grimsteel/slam/pcb/slam.kicad_pcb

## KiCad design pcb/slam.kicad_pcb (2026-07-28)

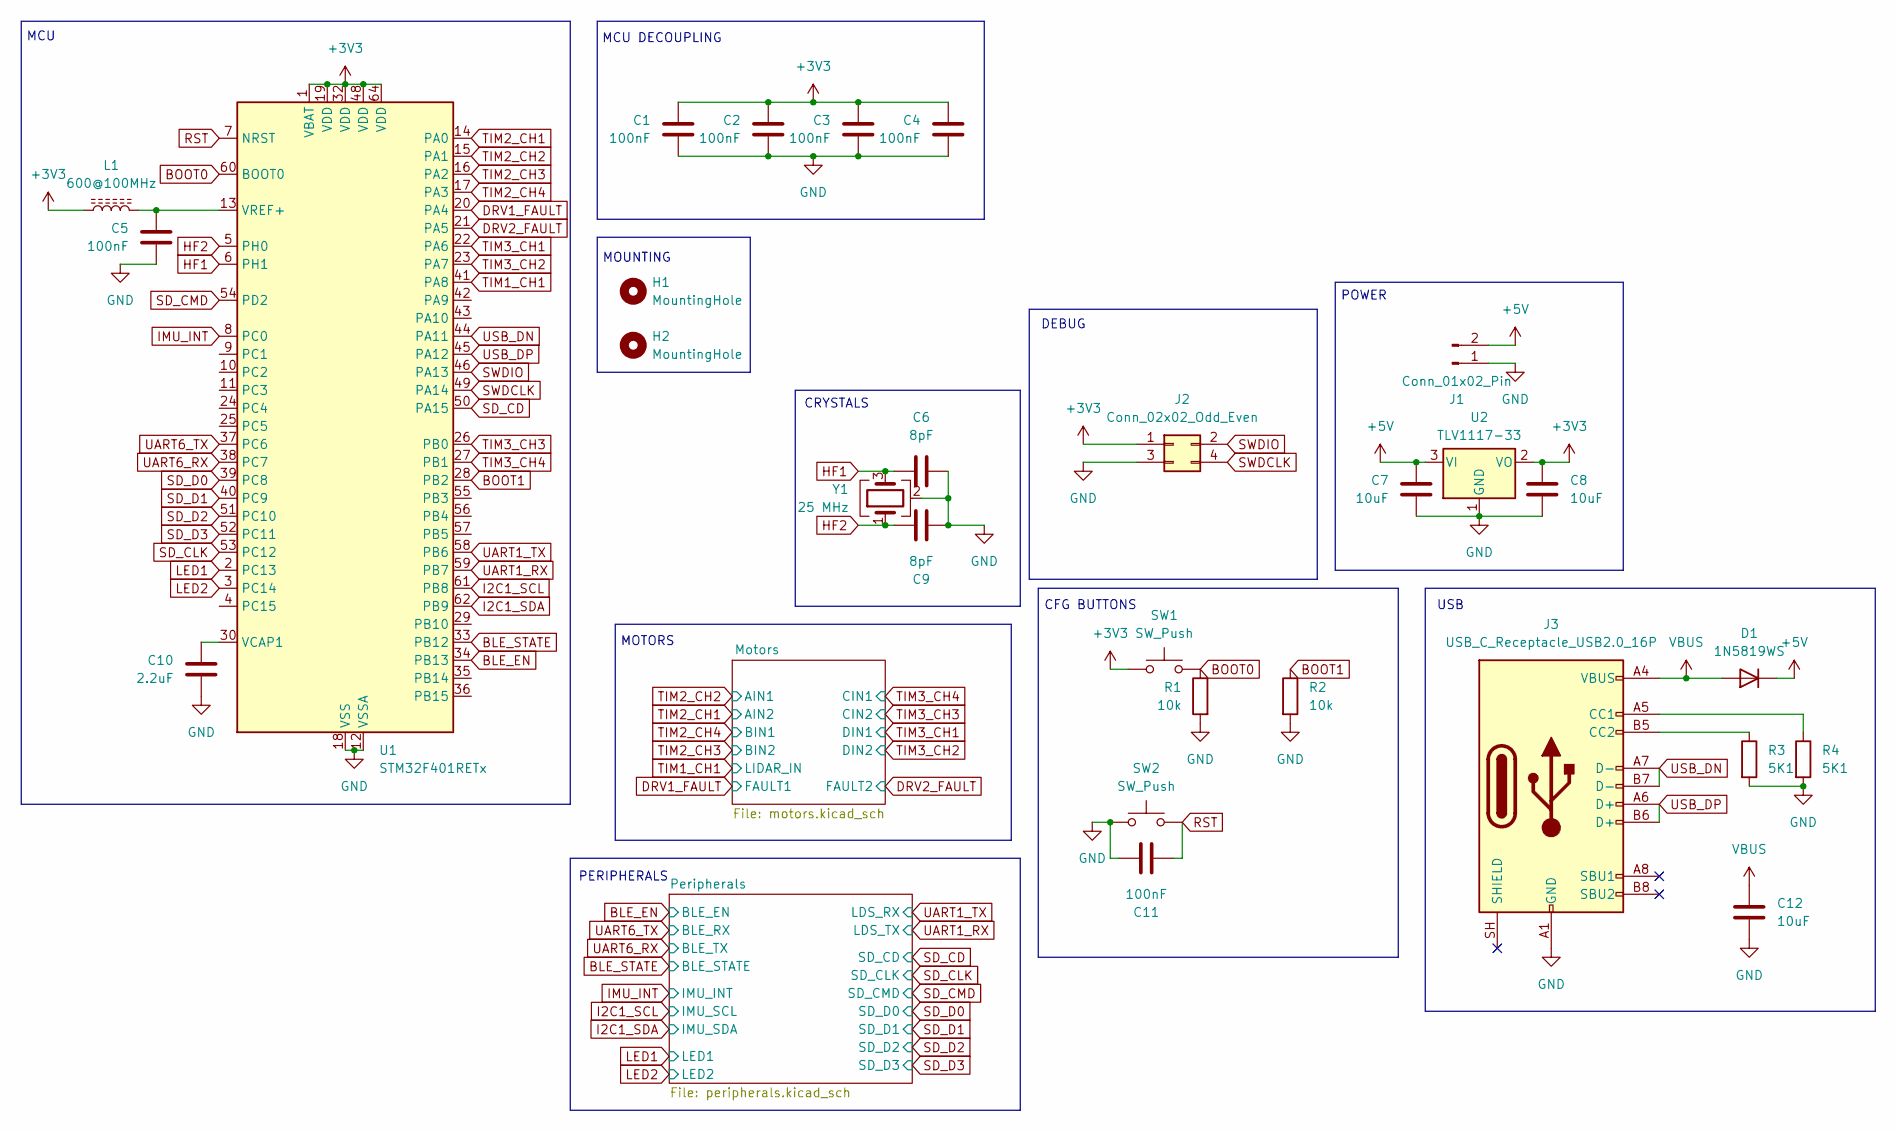
[picture p2: schematic slam.kicad_sch]

Parts:
C1, C2, C3, C4, C5, C11: 100nF; C_0805_2012Metric_Pad1.18x1.45mm_HandSolder; LCSC C3865954
C6, C9: 8pF; C_0603_1608Metric_Pad1.08x0.95mm_HandSolder; LCSC C53308513
C7, C8, C12: 10uF; C_0603_1608Metric_Pad1.08x0.95mm_HandSolder; LCSC C92487
C10: 2.2uF; C_0603_1608Metric_Pad1.08x0.95mm_HandSolder; LCSC C913904
D1: 1N5819WS; D_SOD-123; LCSC C8598
H1, H2: MountingHole; MountingHole_2.2mm_M2
J1: Conn_01x02_Pin; JST_PH_B2B-PH-K_1x02_P2.00mm_Vertical
J2: Conn_02x02_Odd_Even; PinHeader_2x02_P2.54mm_Vertical
J3: USB_C_Receptacle_USB2.0_16P; USB-C-SMD_SHOU_TYPE-C-16P-CB1.6; LCSC C2906290
L1: 600@100MHz; L_0603_1608Metric_Pad1.05x0.95mm_HandSolder; LCSC C133937
R1, R2: 10k; R_0805_2012Metric_Pad1.20x1.40mm_HandSolder; LCSC C2930231
R3, R4: 5K1; R_0603_1608Metric_Pad0.98x0.95mm_HandSolder; LCSC C23186
SW1, SW2: SW_Push; SW-SMD_L4.0-W2.9-LS5.0
U1: STM32F401RETx; LQFP-64_10x10mm_P0.5mm; LCSC C116978
U2: TLV1117-33; SOT-223-3_TabPin2; LCSC C48937499
Y1: 25 MHz; Crystal_SMD_3225-4Pin_3.2x2.5mm_HandSoldering; LCSC C2901684

Connections:
+3V3: C1.1, C2.1, C3.1, C4.1, C8.1, J2.1, L1.1, SW1.1, U1.1 (VBAT), U1.19 (VDD), U1.32 (VDD), U1.48 (VDD), U1.64 (VDD), U2.2 (VO); also elsewhere on the board
+5V: C7.1, D1.1 (K), J1.2, U2.3 (VI); also elsewhere on the board
BLE_EN: U1.34 (PB13); also elsewhere on the board
BLE_STATE: U1.33 (PB12); also elsewhere on the board
BOOT0: R1.1, SW1.2, U1.60 (BOOT0)
BOOT1: R2.1, U1.28 (PB2)
DRV1_FAULT: U1.20 (PA4); also elsewhere on the board
DRV2_FAULT: U1.21 (PA5); also elsewhere on the board
GND: C1.2, C2.2, C3.2, C4.2, C5.2, C6.1, C7.2, C8.2, C9.1, C10.2, C11.2, C12.2, J1.1, J2.3, J3.A1 (GND), J3.A12 (GND), J3.B1 (GND), J3.B12 (GND), R1.2, R2.2, R3.2, R4.2, SW2.1, U1.12 (VSSA), U1.18 (VSS), U1.31 (VSS), U1.47 (VSS), U1.63 (VSS), U2.1 (GND), Y1.2 (G), Y1.4 (G); also elsewhere on the board
HF1: C6.2, U1.6 (PH1), Y1.3
HF2: C9.2, U1.5 (PH0), Y1.1
I2C1_SCL: U1.61 (PB8); also elsewhere on the board
I2C1_SDA: U1.62 (PB9); also elsewhere on the board
IMU_INT: U1.8 (PC0); also elsewhere on the board
LED1: U1.2 (PC13); also elsewhere on the board
LED2: U1.3 (PC14); also elsewhere on the board
unnamed: J3.A5 (CC1), R4.1
unnamed: J3.B5 (CC2), R3.1
unnamed: C10.1, U1.30 (VCAP1)
unnamed: C5.1, L1.2, U1.13 (VREF+)
RST: C11.1, SW2.2, U1.7 (NRST)
SD_CD: U1.50 (PA15); also elsewhere on the board
SD_CLK: U1.53 (PC12); also elsewhere on the board
SD_CMD: U1.54 (PD2); also elsewhere on the board
SD_D0: U1.39 (PC8); also elsewhere on the board
SD_D1: U1.40 (PC9); also elsewhere on the board
SD_D2: U1.51 (PC10); also elsewhere on the board
SD_D3: U1.52 (PC11); also elsewhere on the board
SWDCLK: J2.4, U1.49 (PA14)
SWDIO: J2.2, U1.46 (PA13)
TIM1_CH1: U1.41 (PA8); also elsewhere on the board
TIM2_CH1: U1.14 (PA0); also elsewhere on the board
TIM2_CH2: U1.15 (PA1); also elsewhere on the board
TIM2_CH3: U1.16 (PA2); also elsewhere on the board
TIM2_CH4: U1.17 (PA3); also elsewhere on the board
TIM3_CH1: U1.22 (PA6); also elsewhere on the board
TIM3_CH2: U1.23 (PA7); also elsewhere on the board
TIM3_CH3: U1.26 (PB0); also elsewhere on the board
TIM3_CH4: U1.27 (PB1); also elsewhere on the board
UART1_RX: U1.59 (PB7); also elsewhere on the board
UART1_TX: U1.58 (PB6); also elsewhere on the board
UART6_RX: U1.38 (PC7); also elsewhere on the board
UART6_TX: U1.37 (PC6); also elsewhere on the board
USB_DN: J3.A7 (D-), J3.B7 (D-), U1.44 (PA11)
USB_DP: J3.A6 (D+), J3.B6 (D+), U1.45 (PA12)
VBUS: C12.1, D1.2 (A), J3.A4 (VBUS), J3.A9 (VBUS), J3.B4 (VBUS), J3.B9 (VBUS)

Notes on the sheet:
DEBUG
USB
CRYSTALS
PERIPHERALS
MOTORS
MOUNTING
POWER
MCU
CFG BUTTONS
MCU DECOUPLING

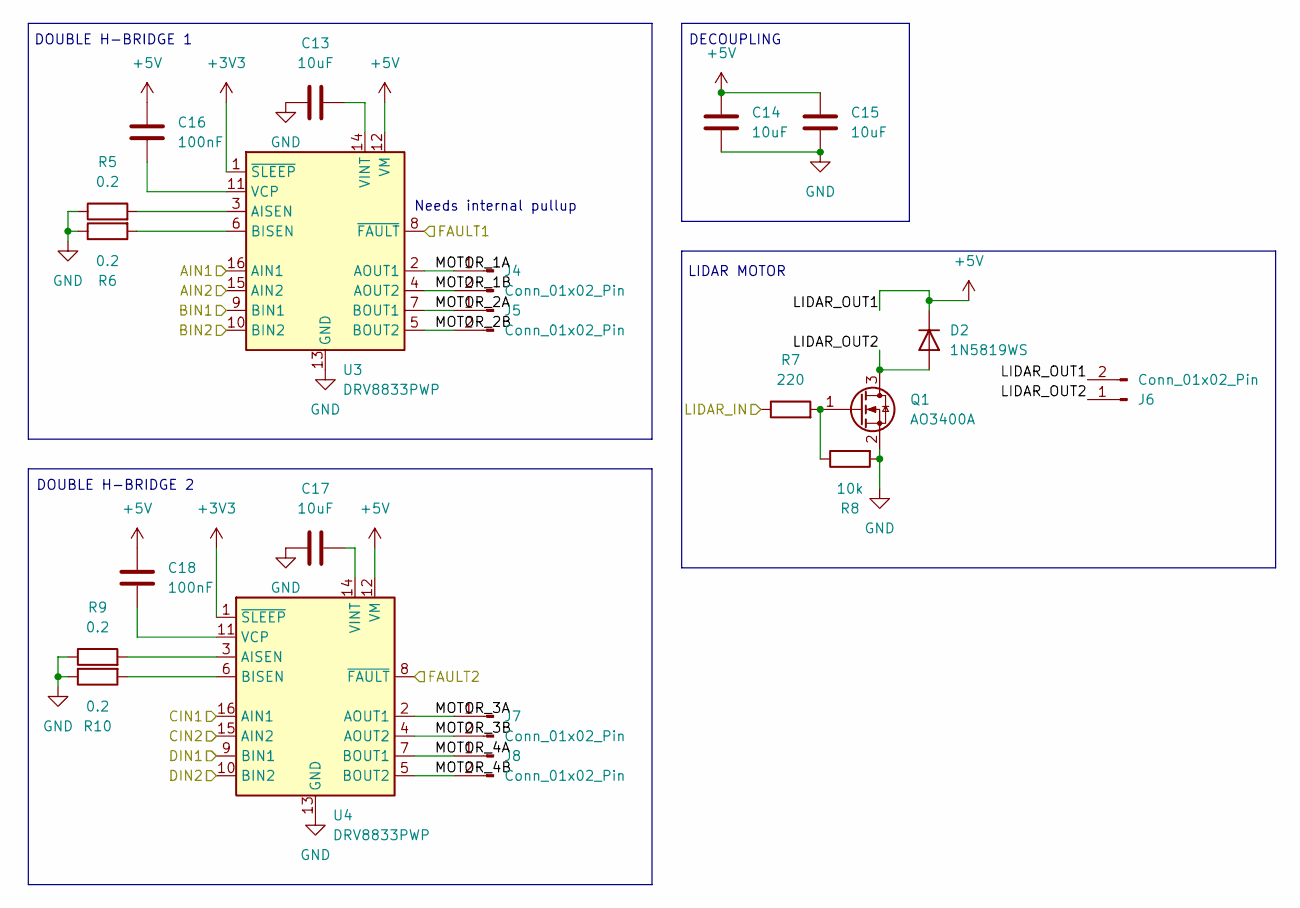
[picture p3: schematic motors.kicad_sch]

Parts:
C13, C14, C15, C17: 10uF; C_0603_1608Metric_Pad1.08x0.95mm_HandSolder; LCSC C92487
C16, C18: 100nF; C_0805_2012Metric_Pad1.18x1.45mm_HandSolder; LCSC C3865954
D2: 1N5819WS; D_SOD-123; LCSC C8598
J4, J5, J7, J8: Conn_01x02_Pin; SolderWire-0.15sqmm_1x02_P4mm_D0.5mm_OD1.5mm
J6: Conn_01x02_Pin; JST_PH_B2B-PH-K_1x02_P2.00mm_Vertical
Q1: AO3400A; SOT-23_Handsoldering; LCSC C347475
R5, R6, R9, R10: 0.2; R_1206_3216Metric_Pad1.30x1.75mm_HandSolder; LCSC C859989
R7: 220; R_0805_2012Metric_Pad1.20x1.40mm_HandSolder; LCSC C2933537
R8: 10k; R_0805_2012Metric_Pad1.20x1.40mm_HandSolder; LCSC C2930231
U3, U4: DRV8833PWP; HTSSOP-16-1EP_4.4x5mm_P0.65mm_EP3.4x5mm_Mask2.46x2.31mm; LCSC C50506

Connections:
+3V3: U3.1 (~SLEEP), U4.1 (~SLEEP); also elsewhere on the board
+5V: C14.2, C15.2, C16.1, C18.1, D2.1 (K), J6.2, U3.12 (VM), U4.12 (VM); also elsewhere on the board
/Motors/LIDAR_OUT2: D2.2 (A), J6.1, Q1.3 (D)
/Motors/MOTOR_1A: J4.1, U3.2 (AOUT1)
/Motors/MOTOR_1B: J4.2, U3.4 (AOUT2)
/Motors/MOTOR_2A: J5.1, U3.7 (BOUT1)
/Motors/MOTOR_2B: J5.2, U3.5 (BOUT2)
/Motors/MOTOR_3A: J7.1, U4.2 (AOUT1)
/Motors/MOTOR_3B: J7.2, U4.4 (AOUT2)
/Motors/MOTOR_4A: J8.1, U4.7 (BOUT1)
/Motors/MOTOR_4B: J8.2, U4.5 (BOUT2)
DRV1_FAULT: U3.8 (~FAULT); also elsewhere on the board
DRV2_FAULT: U4.8 (~FAULT); also elsewhere on the board
GND: C13.2, C14.1, C15.1, C17.2, Q1.2 (S), R5.1, R6.1, R8.2, R9.1, R10.1, U3.13 (GND), U3.17 (GND), U4.13 (GND), U4.17 (GND); also elsewhere on the board
unnamed: Q1.1 (G), R7.2, R8.1
unnamed: R5.2, U3.3 (AISEN)
unnamed: R6.2, U3.6 (BISEN)
unnamed: C16.2, U3.11 (VCP)
unnamed: C13.1, U3.14 (VINT)
unnamed: R9.2, U4.3 (AISEN)
unnamed: R10.2, U4.6 (BISEN)
unnamed: C18.2, U4.11 (VCP)
unnamed: C17.1, U4.14 (VINT)
TIM1_CH1: R7.1; also elsewhere on the board
TIM2_CH1: U3.15 (AIN2); also elsewhere on the board
TIM2_CH2: U3.16 (AIN1); also elsewhere on the board
TIM2_CH3: U3.10 (BIN2); also elsewhere on the board
TIM2_CH4: U3.9 (BIN1); also elsewhere on the board
TIM3_CH1: U4.9 (BIN1); also elsewhere on the board
TIM3_CH2: U4.10 (BIN2); also elsewhere on the board
TIM3_CH3: U4.15 (AIN2); also elsewhere on the board
TIM3_CH4: U4.16 (AIN1); also elsewhere on the board

Notes on the sheet:
DOUBLE H-BRIDGE 2
DECOUPLING
DOUBLE H-BRIDGE 1
LIDAR MOTOR
Needs internal pullup

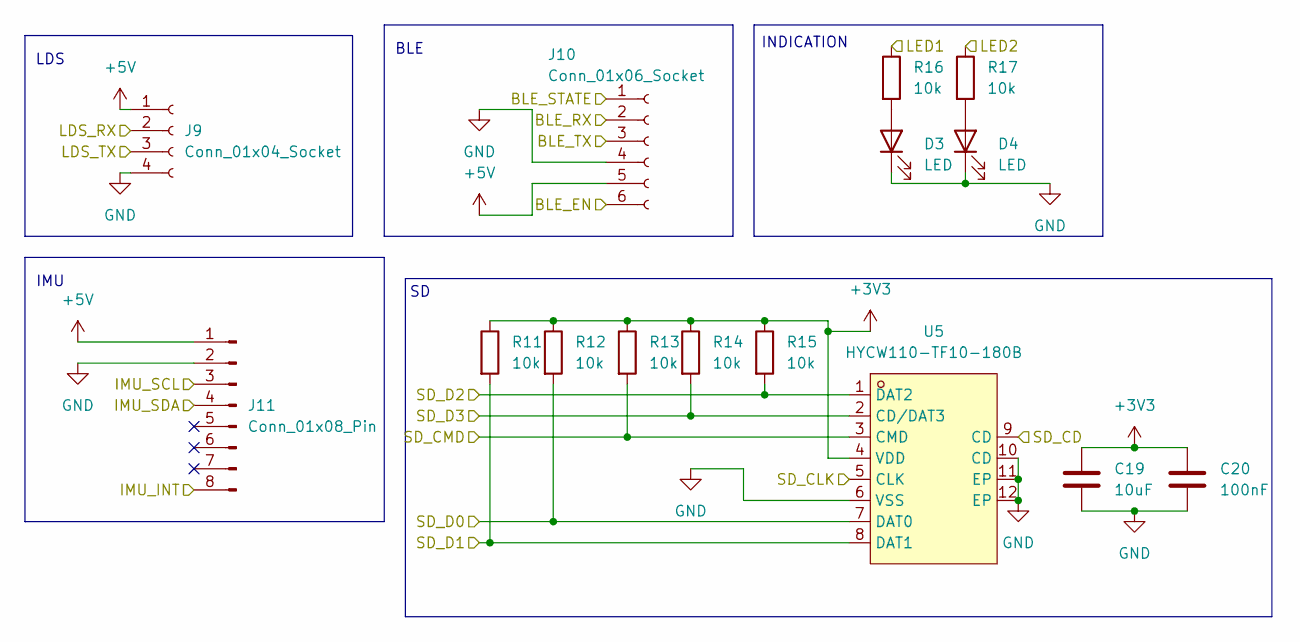
[picture p4: schematic peripherals.kicad_sch]

Parts:
C19: 10uF; C_0603_1608Metric_Pad1.08x0.95mm_HandSolder; LCSC C92487
C20: 100nF; C_0805_2012Metric_Pad1.18x1.45mm_HandSolder; LCSC C3865954
D3, D4: LED; LED_0805_2012Metric; LCSC C19712537
J9: Conn_01x04_Socket; JST_PH_B4B-PH-K_1x04_P2.00mm_Vertical
J10: Conn_01x06_Socket; PinSocket_1x06_P2.54mm_Vertical
J11: Conn_01x08_Pin; PinHeader_1x08_P2.54mm_Vertical
R11, R12, R13, R14, R15, R16, R17: 10k; R_0805_2012Metric_Pad1.20x1.40mm_HandSolder; LCSC C2930231
U5: HYCW110-TF10-180B; SIM-SMD_HYCW110-TF10-180B; MPN HYCW110-TF10-180B; LCSC Part C2962030

Connections:
+3V3: C19.1, C20.1, R11.1, R12.1, R13.1, R14.1, R15.1, U5.4 (VDD); also elsewhere on the board
+5V: J9.1, J10.5, J11.1; also elsewhere on the board
BLE_EN: J10.6; also elsewhere on the board
BLE_STATE: J10.1; also elsewhere on the board
GND: C19.2, C20.2, D3.1 (K), D4.1 (K), J9.4, J10.4, J11.2, U5.6 (VSS), U5.10 (CD), U5.11 (EP), U5.12 (EP); also elsewhere on the board
I2C1_SCL: J11.3; also elsewhere on the board
I2C1_SDA: J11.4; also elsewhere on the board
IMU_INT: J11.8; also elsewhere on the board
LED1: R16.1; also elsewhere on the board
LED2: R17.1; also elsewhere on the board
unnamed: D3.2 (A), R16.2
unnamed: D4.2 (A), R17.2
SD_CD: U5.9 (CD); also elsewhere on the board
SD_CLK: U5.5 (CLK); also elsewhere on the board
SD_CMD: R13.2, U5.3 (CMD); also elsewhere on the board
SD_D0: R12.2, U5.7 (DAT0); also elsewhere on the board
SD_D1: R11.2, U5.8 (DAT1); also elsewhere on the board
SD_D2: R15.2, U5.1 (DAT2); also elsewhere on the board
SD_D3: R14.2, U5.2 (CD/DAT3); also elsewhere on the board
UART1_RX: J9.3; also elsewhere on the board
UART1_TX: J9.2; also elsewhere on the board
UART6_RX: J10.3; also elsewhere on the board
UART6_TX: J10.2; also elsewhere on the board

Notes on the sheet:
IMU
LDS
INDICATION
BLE

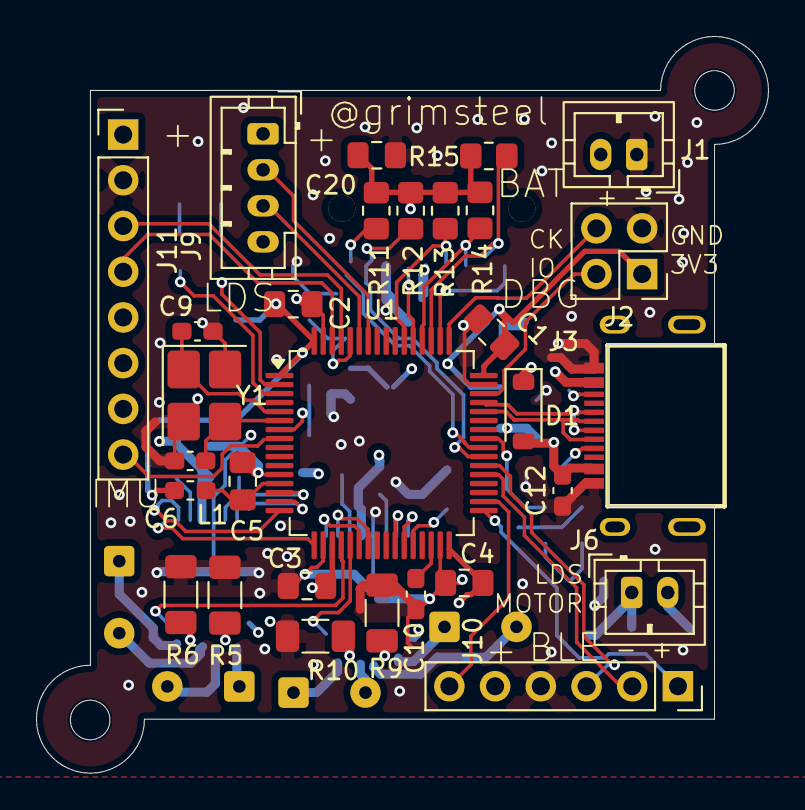
[picture p5: board slam.kicad_pcb from above]

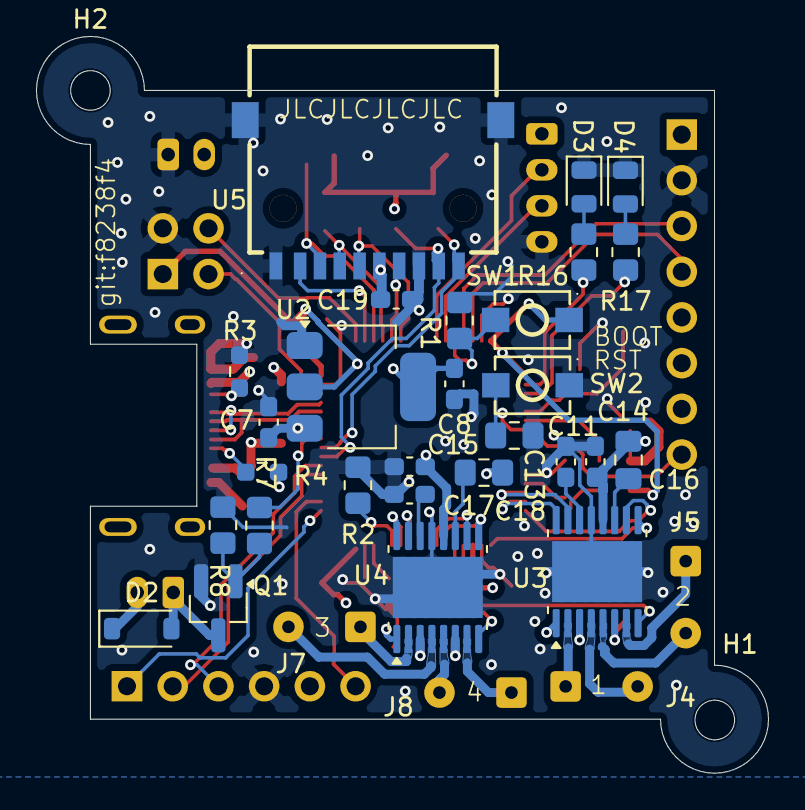
[picture p6: board slam.kicad_pcb from below]

Board: 4 copper layers, 40.7 x 40.9 mm, 64 parts (34 on the bottom side), 66 nets.
