grimsteel/slam/firmware/slam.ioc

Mcu.UserName=STM32F401RETx
PA0-WKUP.Signal=S_TIM2_CH1_ETR
PA1.Signal=S_TIM2_CH2
PA11.Signal=USB_OTG_FS_DM
PA12.Signal=USB_OTG_FS_DP
PA13.Signal=SYS_JTMS-SWDIO
PA14.Signal=SYS_JTCK-SWCLK
PA15.GPIO_Label=SD_CD
PA15.Signal=GPIO_Input
PA2.Signal=S_TIM2_CH3
PA3.Signal=S_TIM2_CH4
PA4.GPIO_Label=DRV1_FAULT
PA4.Signal=GPIO_Input
PA5.GPIO_Label=DRV2_FAULT
PA5.Signal=GPIO_Input
PA6.Signal=S_TIM3_CH1
PA7.Signal=S_TIM3_CH2
PA8.Signal=S_TIM1_CH1
PB0.Signal=S_TIM3_CH3
PB1.Signal=S_TIM3_CH4
PB12.GPIO_Label=BLE_STATE
PB12.Signal=GPIO_Input
PB13.GPIO_Label=BLE_EN
PB13.Signal=GPIO_Output
PB2.GPIO_Label=BOOT1
PB2.Signal=GPIO_Input
PB6.Signal=USART1_TX
PB7.Signal=USART1_RX
PB8.Signal=I2C1_SCL
PB9.Signal=I2C1_SDA
PC0.GPIO_Label=IMU_INT
PC0.Signal=GPXTI0
PC10.Signal=SDIO_D2
PC11.Signal=SDIO_D3
PC12.Signal=SDIO_CK
PC13-ANTI_TAMP.GPIO_Label=LED2
PC13-ANTI_TAMP.Signal=GPIO_Output
PC14-OSC32_IN.GPIO_Label=LED1
PC14-OSC32_IN.Signal=GPIO_Output
PC6.Signal=USART6_TX
PC7.Signal=USART6_RX
PC8.Signal=SDIO_D0
PC9.Signal=SDIO_D1
PD2.Signal=SDIO_CMD
