grimsteel/slam/firmware/Core/Inc/main.h

#define LED2_Pin GPIO_PIN_13
#define LED2_GPIO_Port GPIOC
#define LED1_Pin GPIO_PIN_14
#define LED1_GPIO_Port GPIOC
#define IMU_INT_Pin GPIO_PIN_0
#define IMU_INT_GPIO_Port GPIOC
#define IMU_INT_EXTI_IRQn EXTI0_IRQn
#define DRV1_FAULT_Pin GPIO_PIN_4
#define DRV1_FAULT_GPIO_Port GPIOA
#define DRV2_FAULT_Pin GPIO_PIN_5
#define DRV2_FAULT_GPIO_Port GPIOA
#define BOOT1_Pin GPIO_PIN_2
#define BOOT1_GPIO_Port GPIOB
#define BLE_STATE_Pin GPIO_PIN_12
#define BLE_STATE_GPIO_Port GPIOB
#define BLE_EN_Pin GPIO_PIN_13
#define BLE_EN_GPIO_Port GPIOB
#define SD_CD_Pin GPIO_PIN_15
#define SD_CD_GPIO_Port GPIOA
