grimsteel/slam/(commit log)

2026-06-30 Add pcb
2026-06-30 update diode, usb routing
2026-07-01 cleanup pcb
2026-07-19 pcb update
2026-07-20 cube: fix led pin, cfg usb device
2026-07-28 mx: config pwm
2026-07-28 pcb: fix boot button and some traces
2026-08-04 firmware: add LDS parsing and pid controL
2026-08-04 firmware/cube: configure imu interrupt
2026-10-23 add cad link
